sai-ydev/pibadge/piboard_bom.xlsx

Comment | Designator | Footprint | LCSC Part #
LiPo Battery Connector | J2 | 1x2P | C295747
12MHz | Q1 | SMD3225-4P | C654952
1K | R14 | 402 | C3015791
0.1uF | C1 C2 C5 C6 C7 C8 C9 C10 C11 C12 C13 C14 C22 C23 C25 C27 C29 C43 | 402 | C141382
1.0uF | C3 C4 | 402 | C968773
2.2nH | L2 | 402 | C370207
2.5A/30V/105mÎ© | Q2 | SOT23-3 | C5182052
2K | R13 | 402 | C5140070
4.7K | R5 R6 | 402 | C3152117
4.7uF | C17 C18 | C0402 | C5157687
5.1K | R8 R9 | 402 | C325521
10K | R3 R4 R7 R11 | 402 | C3015825
10uF | C15 C16 | C0402 | C2846677
20K | R15 | 402 | C3015841
20V-1A | D3 | SOD-123 | C5204747
22uF | C42 | AVX-A | C11366
27 | R1 R2 | 402 | C3017455
30pf | C20 C21 | C0402 | C5182450
100K | R16 R17 R18 | 402 | C3015887
220 | R19 | 402 | C3017470
330 | R10 | 402 | C3015774
470 | R12 | 402 | C3015779
470nF 50V | C19 C24 C26 C28 | C0402 | C967572
BLUE-0402 | D1 D2 | LED-0402 | C130724
BMI270 | U2 | XDCR_BMI270 | C2836813
FIDUCIAL1X2 | FD2 FD4 FD6 | FIDUCIAL-1X2 | DNF
ICS-41350 | MK1 | MIC_ICS-41350 | C2895290
IS25LP256D-JLLE-TR | IC1 | SON127P800X600X80-9N | C2886434
IS31FL3737-QFLS4-TR | IC2 | QFN40P500X500X80-41N | C506254
JUMPER-SMT_2_NO_SILK_ROUND | JP1 | SMT-JUMPER_2_NO_SILK_ROUND | DNF
MCP73831T-2ATI/OT | U4 | SOT95P280X145-5N | C14879
MIC5504-3.3YM5_TR | U3 | SOT95P280X145-5N | C3021093
MOMENTARY-SWITCH-SPST-SMD-4.6X2.8MM | S1 S2 S3 | TACTILE_SWITCH_SMD_4.6X2.8MM | C99271
PCM12SMTR | SW1 | SW_PCM12SMTR | C221841
RED-0402 | D4 | LED-0402 | C130719
RP2040 | U1 | QFN40P700X700X90-57N | C2040
TYPE-C-31-M-12 | J1 | HRO_TYPE-C-31-M-12 | C165948
19-337C/RSBHGHC-A88/4T | RGB1 RGB2 RGB3 RGB4 RGB5 RGB6 RGB7 RGB8 RGB9 RGB10 RGB11 RGB12 RGB13 RGB14 RGB15 RGB16 RGB17 RGB18 RGB19 RGB20 RGB21 RGB22 RGB23 RGB24 RGB25 RGB26 RGB27 RGB28 RGB29 RGB30 RGB31 RGB32 RGB33 RGB34 RGB35 RGB36 RGB37 RGB38 RGB39 RGB40 RGB41 RGB42 RGB43 RGB44 RGB45 RGB46 RGB47 RGB48 | LED_19-337C/RSBHGHC-A88/4T | C3019536
100nf | C30 C31 C32 C33 C34 C35 C36 C37 C38 C39 C40 C41 | C0402 | C141382
FIDUCIAL1X2 | FD1 FD3 FD5 | FIDUCIAL-1X2 | DNF
WS2812B-2020 | LED1 LED2 LED3 LED4 LED5 LED6 LED7 LED8 LED9 LED10 LED11 LED12 | WS2812B-2020 | C965555
