sai-ydev/pibadge/piboard.brd

## EAGLE design piboard.brd (2023-02-13)

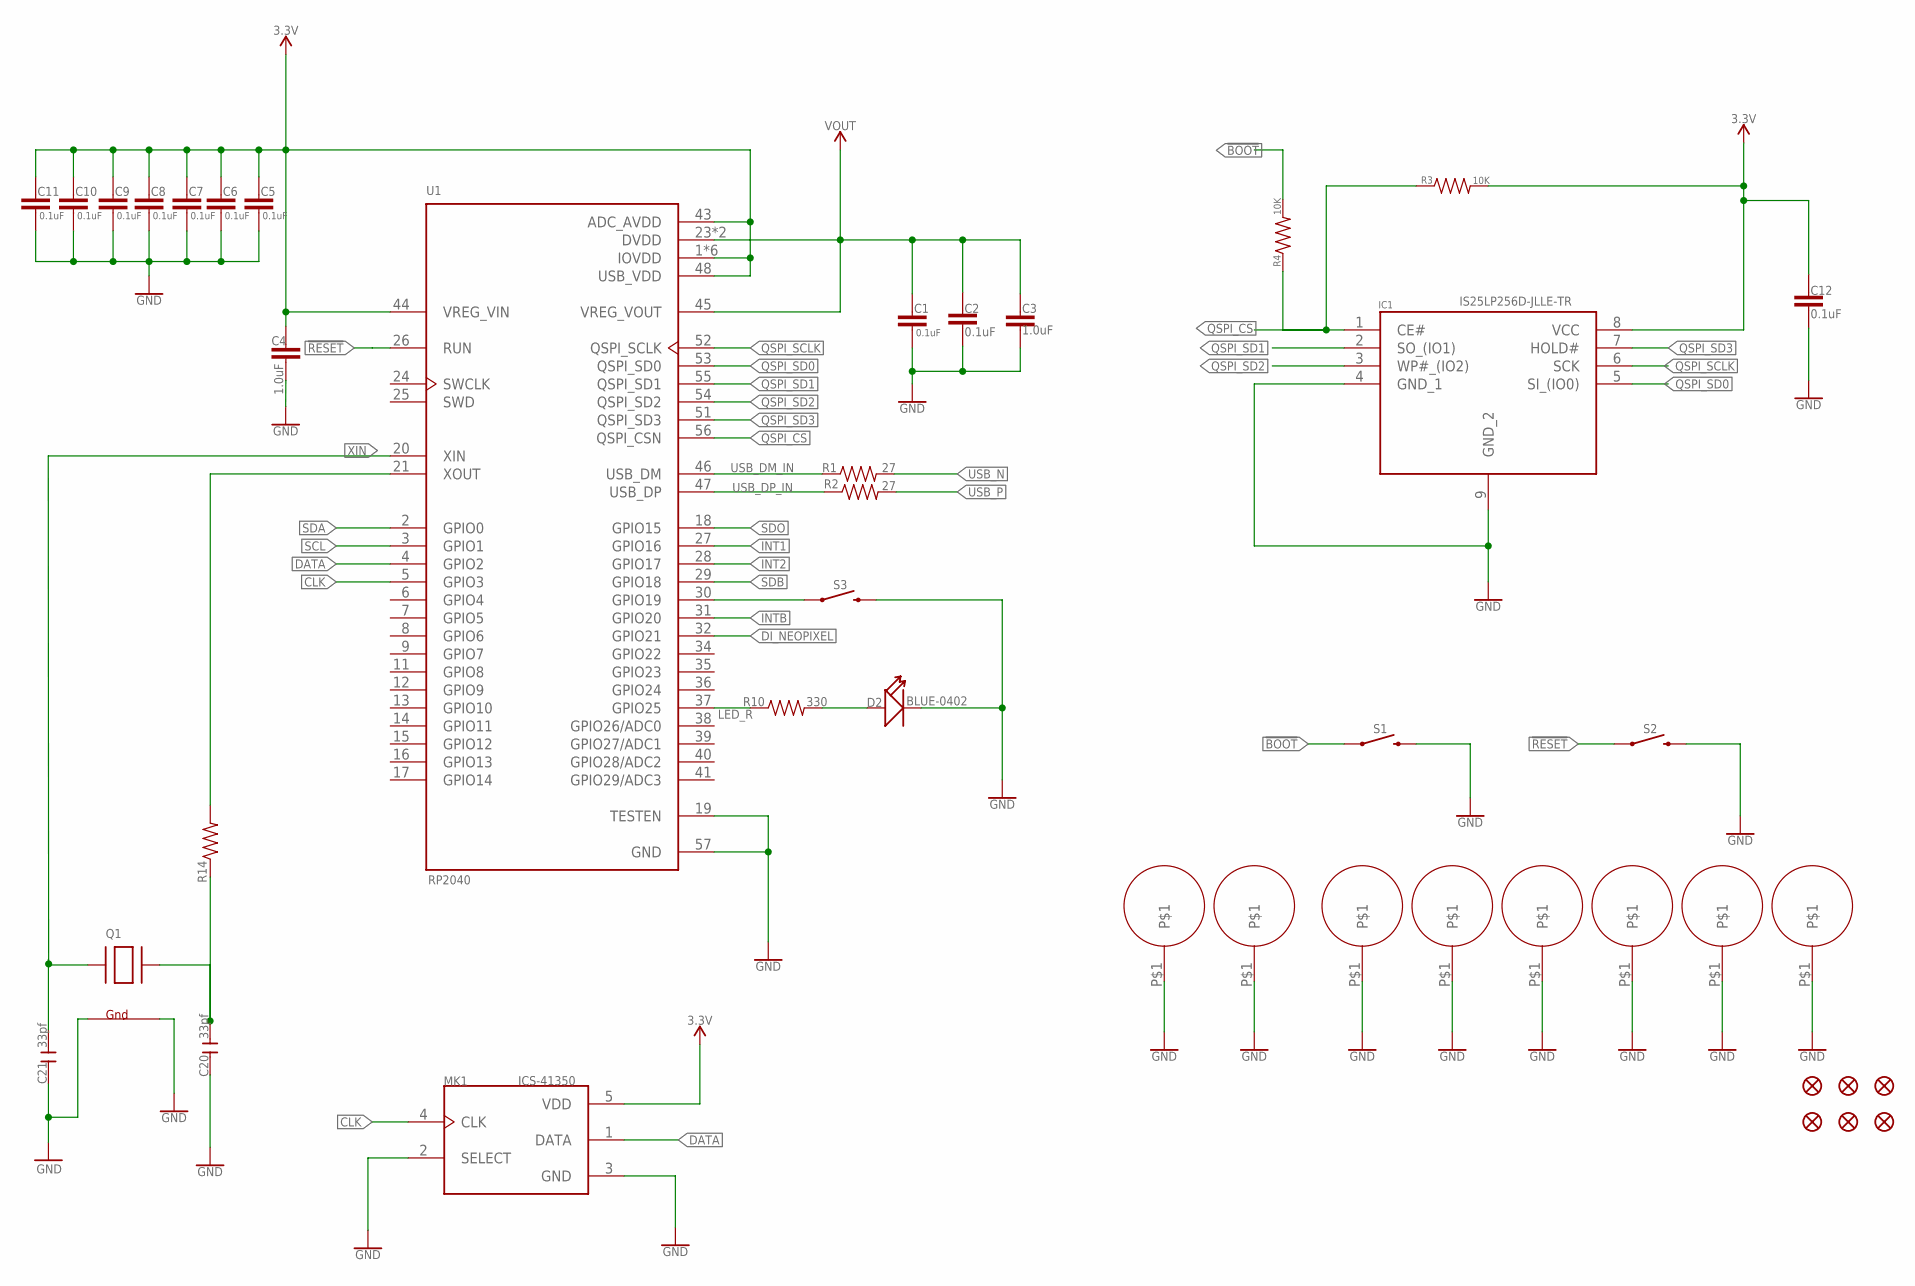
[picture p1: schematic piboard.sch, sheet 1]

Parts:
C1, C2, C5, C6, C7, C8, C9, C10, C11, C12: 0.1uF; 0402
C3, C4: 1.0uF; 0402
C20, C21: 33pf; C0402
D2: BLUE-0402; LED-0402
FD1, FD2, FD3, FD4, FD5, FD6: FIDUCIAL1X2; FIDUCIAL-1X2
H1, H2, H3, H4, H5, H6, H7, H8: M25
IC1: IS25LP256D-JLLE-TR; SON127P800X600X80-9N
MK1: ICS-41350; MIC_ICS-41350
Q1: XTAL-4-3225; NX3225
R1, R2: 27; 0402
R3, R4: 10K; 0402
R10: 330; 0402
R14: 0402
S1, S2, S3: MOMENTARY-SWITCH-SPST-SMD-4.6X2.8MM; TACTILE_SWITCH_SMD_4.6X2.8MM
U1: RP2040; QFN40P700X700X90-57N

Connections:
3.3V: C4.1, C5.1, C6.1, C7.1, C8.1, C9.1, C10.1, C11.1, C12.1, IC1.8 (VCC), MK1.5 (VDD), R3.2, U1.1 (IOVDD), U1.10 (IOVDD), U1.22 (IOVDD), U1.33 (IOVDD), U1.42 (IOVDD), U1.43 (ADC_AVDD), U1.44 (VREG_VIN), U1.48 (USB_VDD), U1.49 (IOVDD); also elsewhere on the board
!BOOT: R4.2, S1.1, S1.2 (1)
!RESET: S2.1, S2.2 (1), U1.26 (RUN)
CLK: MK1.4 (CLK), U1.5 (GPIO3)
DATA: MK1.1 (DATA), U1.4 (GPIO2)
DI_NEOPIXEL: U1.32 (GPIO21); also elsewhere on the board
GND: C1.2, C2.2, C3.2, C4.2, C5.2, C6.2, C7.2, C8.2, C9.2, C10.2, C11.2, C12.2, C20.1, C21.1, D2.-, H1.P$1, H2.P$1, H3.P$1, H4.P$1, H5.P$1, H6.P$1, H7.P$1, H8.P$1, IC1.4 (GND_1), IC1.9 (GND_2), MK1.2 (SELECT), MK1.3 (GND), Q1.2 (G2), Q1.4 (G1), S1.3 (2), S1.4 (2), S2.3 (2), S2.4 (2), S3.3 (2), S3.4 (2), U1.19 (TESTEN), U1.57 (GND); also elsewhere on the board
INT1: U1.27 (GPIO16); also elsewhere on the board
INT2: U1.28 (GPIO17); also elsewhere on the board
INTB: U1.31 (GPIO20); also elsewhere on the board
LED_R: R10.1, U1.37 (GPIO25)
unnamed: D2.+, R10.2
unnamed: C20.2, Q1.3 (X2), R14.1
unnamed: R14.2, U1.21 (XOUT)
unnamed: S3.1, S3.2 (1), U1.30 (GPIO19)
QSPI_CS: IC1.1 (CE#), R3.1, R4.1, U1.56 (QSPI_CSN)
QSPI_SCLK: IC1.6 (SCK), U1.52 (QSPI_SCLK)
QSPI_SD0: IC1.5 (SI_(IO0)), U1.53 (QSPI_SD0)
QSPI_SD1: IC1.2 (SO_(IO1)), U1.55 (QSPI_SD1)
QSPI_SD2: IC1.3 (WP#_(IO2)), U1.54 (QSPI_SD2)
QSPI_SD3: IC1.7 (HOLD#), U1.51 (QSPI_SD3)
SCL: U1.3 (GPIO1); also elsewhere on the board
SDA: U1.2 (GPIO0); also elsewhere on the board
SDB: U1.29 (GPIO18); also elsewhere on the board
SDO: U1.18 (GPIO15); also elsewhere on the board
USB_DM_IN: R1.1, U1.46 (USB_DM)
USB_DP_IN: R2.1, U1.47 (USB_DP)
USB_N: R1.2; also elsewhere on the board
USB_P: R2.2; also elsewhere on the board
VOUT: C1.1, C2.1, C3.1, U1.23 (DVDD), U1.45 (VREG_VOUT), U1.50 (DVDD)
XIN: C21.2, Q1.1 (X1), U1.20 (XIN)

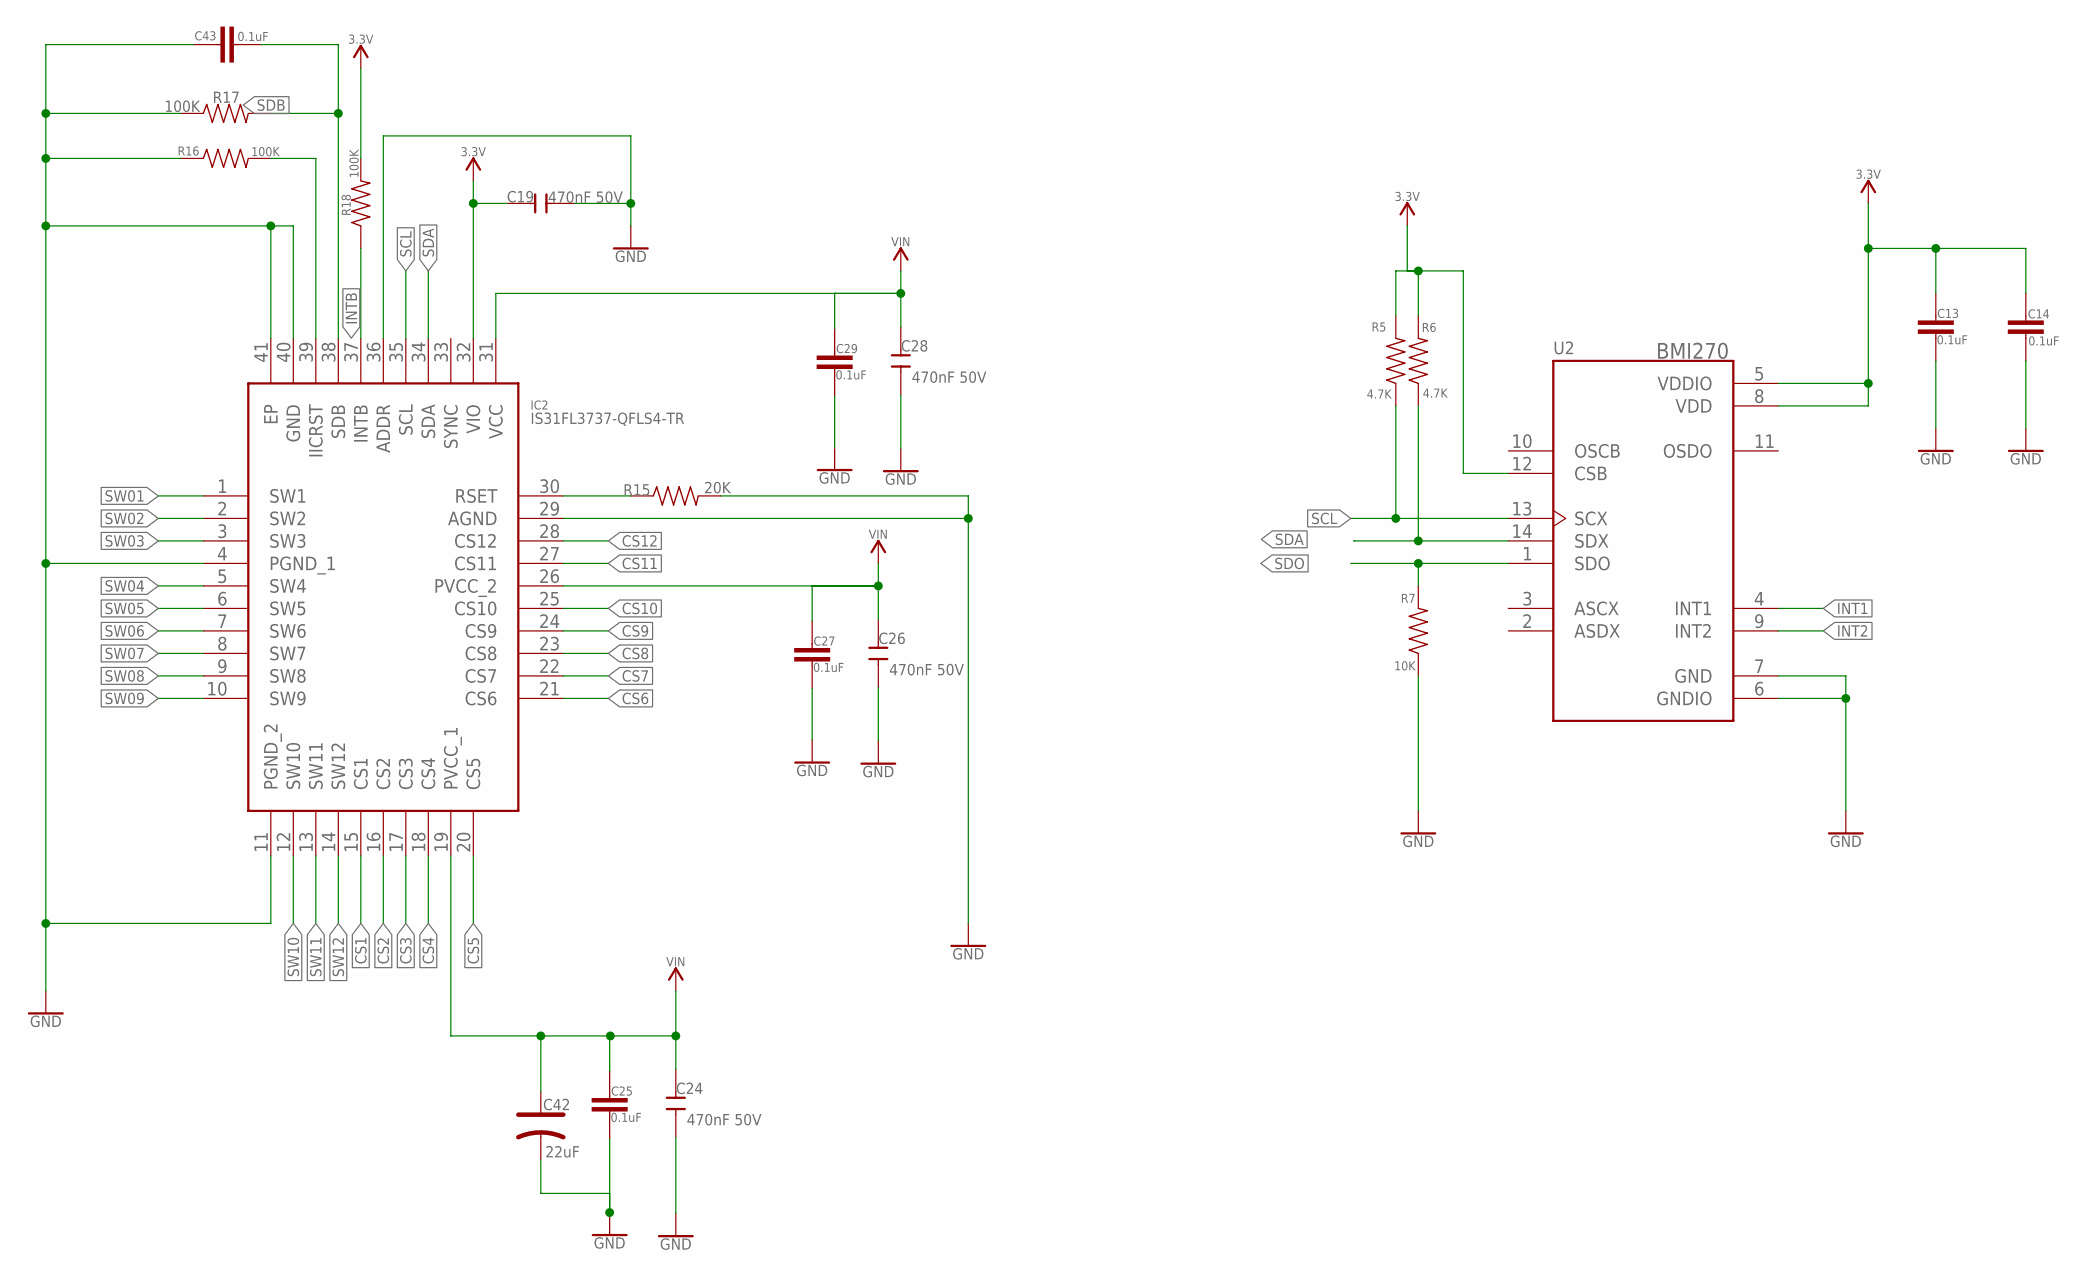
[picture p2: schematic piboard.sch, sheet 2]

Parts:
C13, C14, C25, C27, C29, C43: 0.1uF; 0402
C19, C24, C26, C28: 470nF 50V; C0402
C42: 22uF; AVX-A
IC2: IS31FL3737-QFLS4-TR; QFN40P500X500X80-41N
R5, R6: 4.7K; 0402
R7: 10K; 0402
R15: 20K; 0402
R16, R17, R18: 100K; 0402
U2: BMI270; XDCR_BMI270

Connections:
3.3V: C13.1, C14.1, C19.1, IC2.32 (VIO), R5.2, R6.2, R18.2, U2.5 (VDDIO), U2.8 (VDD), U2.12 (CSB); also elsewhere on the board
CS1: IC2.15 (CS1); also elsewhere on the board
CS2: IC2.16 (CS2); also elsewhere on the board
CS3: IC2.17 (CS3); also elsewhere on the board
CS4: IC2.18 (CS4); also elsewhere on the board
CS5: IC2.20 (CS5); also elsewhere on the board
CS6: IC2.21 (CS6); also elsewhere on the board
CS7: IC2.22 (CS7); also elsewhere on the board
CS8: IC2.23 (CS8); also elsewhere on the board
CS9: IC2.24 (CS9); also elsewhere on the board
CS10: IC2.25 (CS10); also elsewhere on the board
CS11: IC2.27 (CS11); also elsewhere on the board
CS12: IC2.28 (CS12); also elsewhere on the board
GND: C13.2, C14.2, C19.2, C24.1, C25.2, C26.1, C27.2, C28.1, C29.2, C42.-, C43.1, IC2.4 (PGND_1), IC2.11 (PGND_2), IC2.29 (AGND), IC2.36 (ADDR), IC2.40 (GND), IC2.41 (EP), R7.1, R15.2, R16.1, R17.1, U2.6 (GNDIO), U2.7 (GND); also elsewhere on the board
INT1: U2.4 (INT1); also elsewhere on the board
INT2: U2.9 (INT2); also elsewhere on the board
INTB: IC2.37 (INTB), R18.1; also elsewhere on the board
unnamed: IC2.30 (RSET), R15.1
unnamed: IC2.39 (IICRST), R16.2
SCL: IC2.35 (SCL), R5.1, U2.13 (SCX); also elsewhere on the board
SDA: IC2.34 (SDA), R6.1, U2.14 (SDX); also elsewhere on the board
SDB: C43.2, IC2.38 (SDB), R17.2; also elsewhere on the board
SDO: R7.2, U2.1 (SDO); also elsewhere on the board
SW01: IC2.1 (SW1); also elsewhere on the board
SW02: IC2.2 (SW2); also elsewhere on the board
SW03: IC2.3 (SW3); also elsewhere on the board
SW04: IC2.5 (SW4); also elsewhere on the board
SW05: IC2.6 (SW5); also elsewhere on the board
SW06: IC2.7 (SW6); also elsewhere on the board
SW07: IC2.8 (SW7); also elsewhere on the board
SW08: IC2.9 (SW8); also elsewhere on the board
SW09: IC2.10 (SW9); also elsewhere on the board
SW10: IC2.12 (SW10); also elsewhere on the board
SW11: IC2.13 (SW11); also elsewhere on the board
SW12: IC2.14 (SW12); also elsewhere on the board
VIN: C24.2, C25.1, C26.2, C27.1, C28.2, C29.1, C42.+, IC2.19 (PVCC_1), IC2.26 (PVCC_2), IC2.31 (VCC); also elsewhere on the board

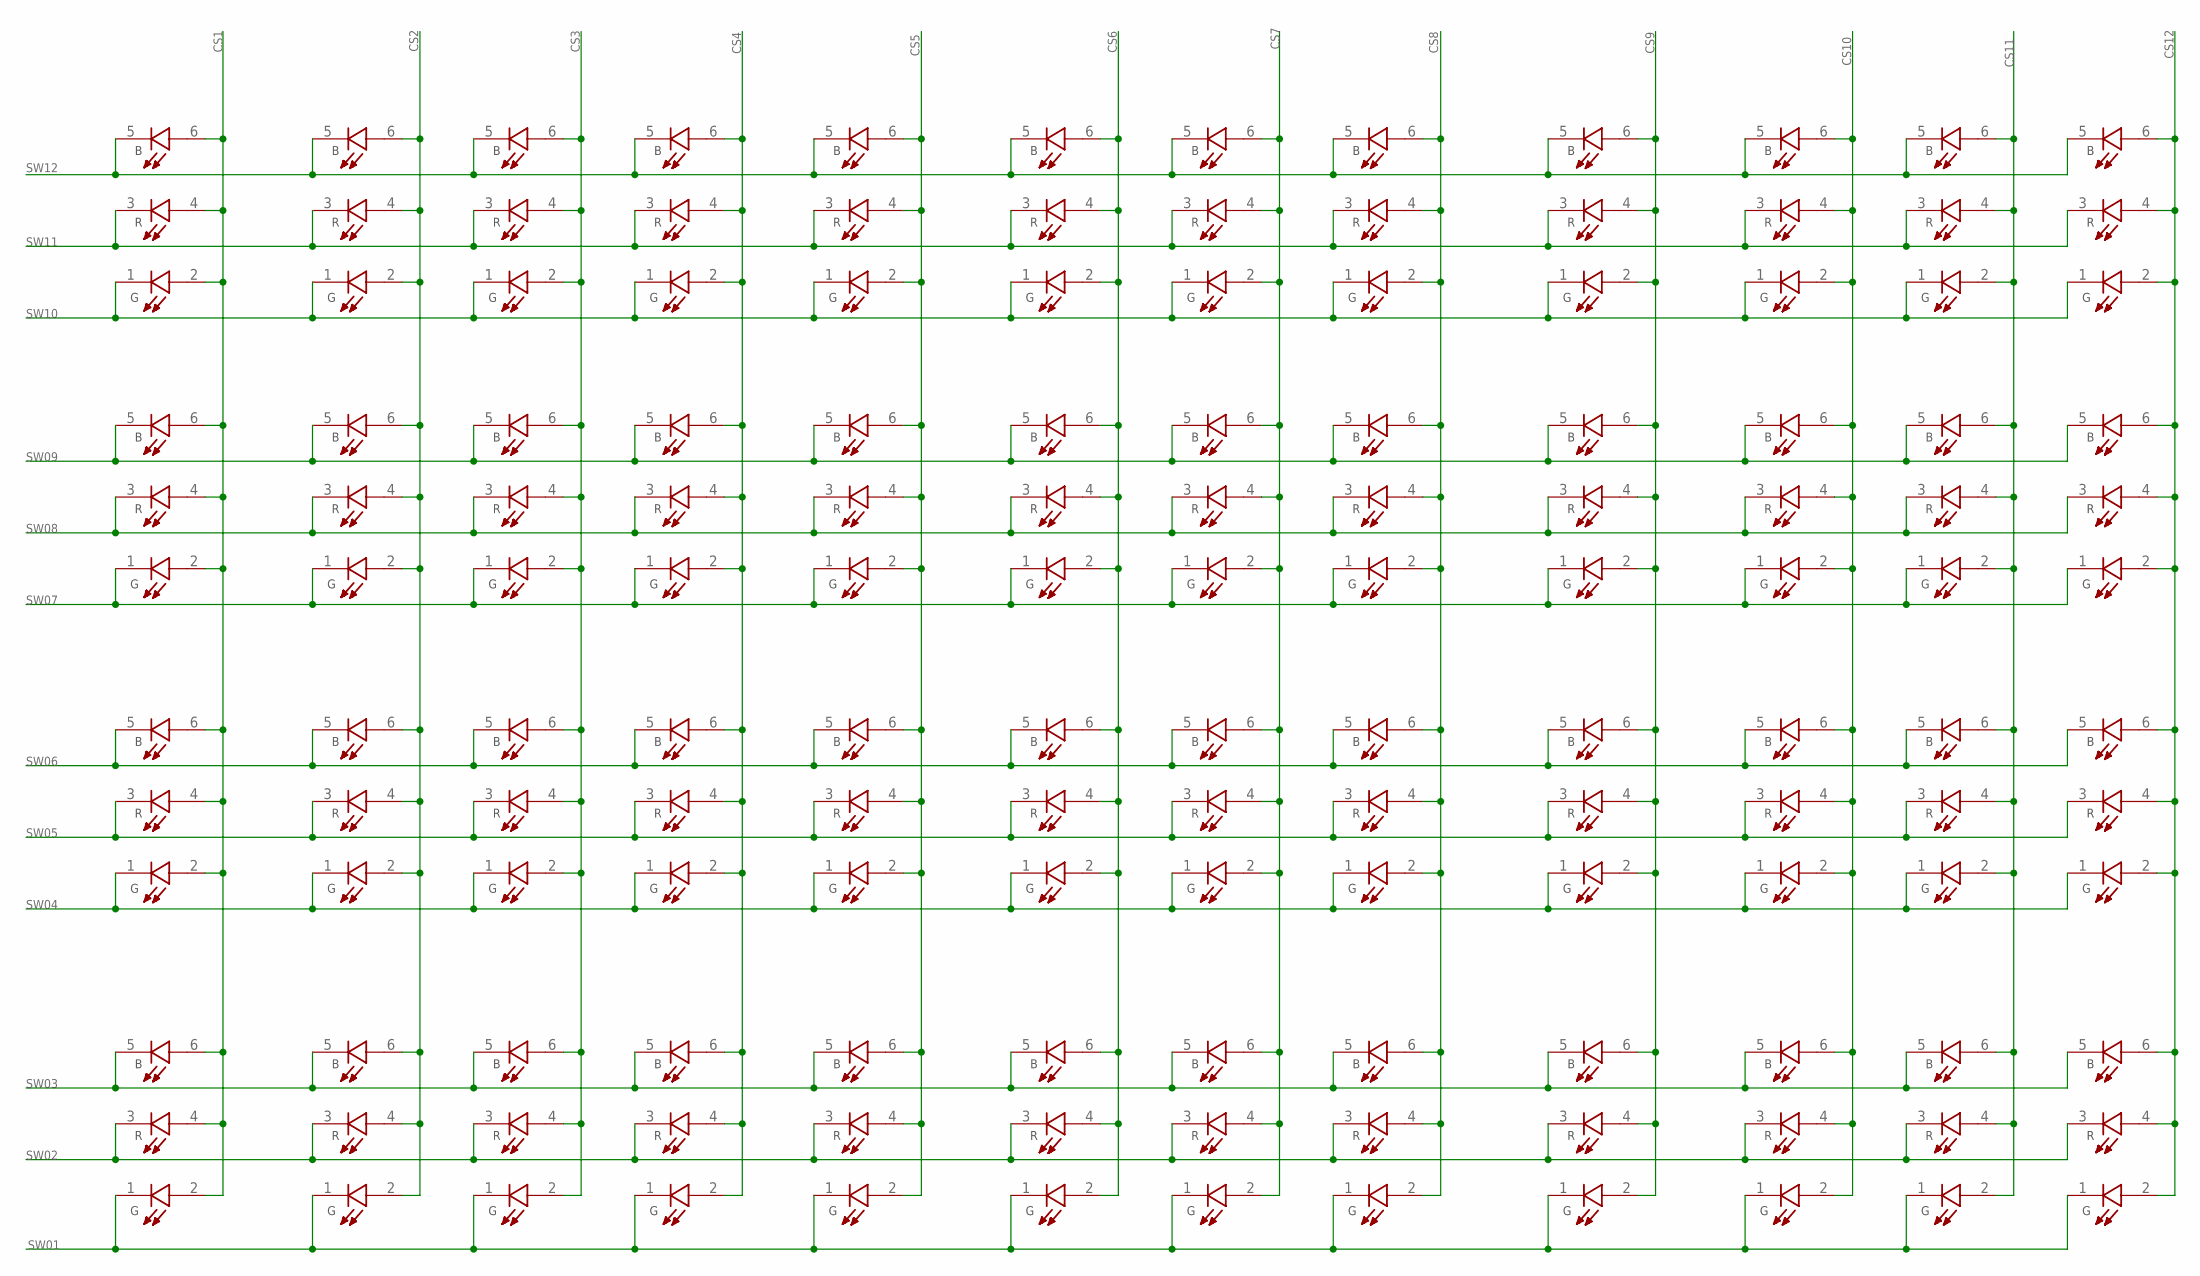
[picture p3: schematic piboard.sch, sheet 3]

Parts:
RGB1, RGB2, RGB3, RGB4, RGB5, RGB6, RGB7, RGB8, RGB9, RGB10, RGB11, RGB12, RGB13, RGB14, RGB15, RGB16, RGB17, RGB18, RGB19, RGB20, RGB21, RGB22, RGB23, RGB24, RGB25, RGB26, RGB27, RGB28, RGB29, RGB30, RGB31, RGB32, RGB33, RGB34, RGB35, RGB36, RGB37, RGB38, RGB39, RGB40, RGB41, RGB42, RGB43, RGB44, RGB45, RGB46, RGB47, RGB48: 19-337C/RSBHGHC-A88/4T; LED_19-337C/RSBHGHC-A88/4T

Connections:
CS1: RGB1.2 (G_A), RGB1.4 (R_A), RGB1.6 (B_A), RGB13.2 (G_A), RGB13.4 (R_A), RGB13.6 (B_A), RGB25.2 (G_A), RGB25.4 (R_A), RGB25.6 (B_A), RGB37.2 (G_A), RGB37.4 (R_A), RGB37.6 (B_A); also elsewhere on the board
CS2: RGB2.2 (G_A), RGB2.4 (R_A), RGB2.6 (B_A), RGB14.2 (G_A), RGB14.4 (R_A), RGB14.6 (B_A), RGB26.2 (G_A), RGB26.4 (R_A), RGB26.6 (B_A), RGB38.2 (G_A), RGB38.4 (R_A), RGB38.6 (B_A); also elsewhere on the board
CS3: RGB3.2 (G_A), RGB3.4 (R_A), RGB3.6 (B_A), RGB15.2 (G_A), RGB15.4 (R_A), RGB15.6 (B_A), RGB27.2 (G_A), RGB27.4 (R_A), RGB27.6 (B_A), RGB39.2 (G_A), RGB39.4 (R_A), RGB39.6 (B_A); also elsewhere on the board
CS4: RGB4.2 (G_A), RGB4.4 (R_A), RGB4.6 (B_A), RGB16.2 (G_A), RGB16.4 (R_A), RGB16.6 (B_A), RGB28.2 (G_A), RGB28.4 (R_A), RGB28.6 (B_A), RGB40.2 (G_A), RGB40.4 (R_A), RGB40.6 (B_A); also elsewhere on the board
CS5: RGB5.2 (G_A), RGB5.4 (R_A), RGB5.6 (B_A), RGB17.2 (G_A), RGB17.4 (R_A), RGB17.6 (B_A), RGB29.2 (G_A), RGB29.4 (R_A), RGB29.6 (B_A), RGB41.2 (G_A), RGB41.4 (R_A), RGB41.6 (B_A); also elsewhere on the board
CS6: RGB6.2 (G_A), RGB6.4 (R_A), RGB6.6 (B_A), RGB18.2 (G_A), RGB18.4 (R_A), RGB18.6 (B_A), RGB30.2 (G_A), RGB30.4 (R_A), RGB30.6 (B_A), RGB42.2 (G_A), RGB42.4 (R_A), RGB42.6 (B_A); also elsewhere on the board
CS7: RGB7.2 (G_A), RGB7.4 (R_A), RGB7.6 (B_A), RGB19.2 (G_A), RGB19.4 (R_A), RGB19.6 (B_A), RGB31.2 (G_A), RGB31.4 (R_A), RGB31.6 (B_A), RGB43.2 (G_A), RGB43.4 (R_A), RGB43.6 (B_A); also elsewhere on the board
CS8: RGB8.2 (G_A), RGB8.4 (R_A), RGB8.6 (B_A), RGB20.2 (G_A), RGB20.4 (R_A), RGB20.6 (B_A), RGB32.2 (G_A), RGB32.4 (R_A), RGB32.6 (B_A), RGB44.2 (G_A), RGB44.4 (R_A), RGB44.6 (B_A); also elsewhere on the board
CS9: RGB9.2 (G_A), RGB9.4 (R_A), RGB9.6 (B_A), RGB21.2 (G_A), RGB21.4 (R_A), RGB21.6 (B_A), RGB33.2 (G_A), RGB33.4 (R_A), RGB33.6 (B_A), RGB45.2 (G_A), RGB45.4 (R_A), RGB45.6 (B_A); also elsewhere on the board
CS10: RGB10.2 (G_A), RGB10.4 (R_A), RGB10.6 (B_A), RGB22.2 (G_A), RGB22.4 (R_A), RGB22.6 (B_A), RGB34.2 (G_A), RGB34.4 (R_A), RGB34.6 (B_A), RGB46.2 (G_A), RGB46.4 (R_A), RGB46.6 (B_A); also elsewhere on the board
CS11: RGB11.2 (G_A), RGB11.4 (R_A), RGB11.6 (B_A), RGB23.2 (G_A), RGB23.4 (R_A), RGB23.6 (B_A), RGB35.2 (G_A), RGB35.4 (R_A), RGB35.6 (B_A), RGB47.2 (G_A), RGB47.4 (R_A), RGB47.6 (B_A); also elsewhere on the board
CS12: RGB12.2 (G_A), RGB12.4 (R_A), RGB12.6 (B_A), RGB24.2 (G_A), RGB24.4 (R_A), RGB24.6 (B_A), RGB36.2 (G_A), RGB36.4 (R_A), RGB36.6 (B_A), RGB48.2 (G_A), RGB48.4 (R_A), RGB48.6 (B_A); also elsewhere on the board
SW01: RGB37.1 (G_C), RGB38.1 (G_C), RGB39.1 (G_C), RGB40.1 (G_C), RGB41.1 (G_C), RGB42.1 (G_C), RGB43.1 (G_C), RGB44.1 (G_C), RGB45.1 (G_C), RGB46.1 (G_C), RGB47.1 (G_C), RGB48.1 (G_C); also elsewhere on the board
SW02: RGB37.3 (R_C), RGB38.3 (R_C), RGB39.3 (R_C), RGB40.3 (R_C), RGB41.3 (R_C), RGB42.3 (R_C), RGB43.3 (R_C), RGB44.3 (R_C), RGB45.3 (R_C), RGB46.3 (R_C), RGB47.3 (R_C), RGB48.3 (R_C); also elsewhere on the board
SW03: RGB37.5 (B_C), RGB38.5 (B_C), RGB39.5 (B_C), RGB40.5 (B_C), RGB41.5 (B_C), RGB42.5 (B_C), RGB43.5 (B_C), RGB44.5 (B_C), RGB45.5 (B_C), RGB46.5 (B_C), RGB47.5 (B_C), RGB48.5 (B_C); also elsewhere on the board
SW04: RGB25.1 (G_C), RGB26.1 (G_C), RGB27.1 (G_C), RGB28.1 (G_C), RGB29.1 (G_C), RGB30.1 (G_C), RGB31.1 (G_C), RGB32.1 (G_C), RGB33.1 (G_C), RGB34.1 (G_C), RGB35.1 (G_C), RGB36.1 (G_C); also elsewhere on the board
SW05: RGB25.3 (R_C), RGB26.3 (R_C), RGB27.3 (R_C), RGB28.3 (R_C), RGB29.3 (R_C), RGB30.3 (R_C), RGB31.3 (R_C), RGB32.3 (R_C), RGB33.3 (R_C), RGB34.3 (R_C), RGB35.3 (R_C), RGB36.3 (R_C); also elsewhere on the board
SW06: RGB25.5 (B_C), RGB26.5 (B_C), RGB27.5 (B_C), RGB28.5 (B_C), RGB29.5 (B_C), RGB30.5 (B_C), RGB31.5 (B_C), RGB32.5 (B_C), RGB33.5 (B_C), RGB34.5 (B_C), RGB35.5 (B_C), RGB36.5 (B_C); also elsewhere on the board
SW07: RGB13.1 (G_C), RGB14.1 (G_C), RGB15.1 (G_C), RGB16.1 (G_C), RGB17.1 (G_C), RGB18.1 (G_C), RGB19.1 (G_C), RGB20.1 (G_C), RGB21.1 (G_C), RGB22.1 (G_C), RGB23.1 (G_C), RGB24.1 (G_C); also elsewhere on the board
SW08: RGB13.3 (R_C), RGB14.3 (R_C), RGB15.3 (R_C), RGB16.3 (R_C), RGB17.3 (R_C), RGB18.3 (R_C), RGB19.3 (R_C), RGB20.3 (R_C), RGB21.3 (R_C), RGB22.3 (R_C), RGB23.3 (R_C), RGB24.3 (R_C); also elsewhere on the board
SW09: RGB13.5 (B_C), RGB14.5 (B_C), RGB15.5 (B_C), RGB16.5 (B_C), RGB17.5 (B_C), RGB18.5 (B_C), RGB19.5 (B_C), RGB20.5 (B_C), RGB21.5 (B_C), RGB22.5 (B_C), RGB23.5 (B_C), RGB24.5 (B_C); also elsewhere on the board
SW10: RGB1.1 (G_C), RGB2.1 (G_C), RGB3.1 (G_C), RGB4.1 (G_C), RGB5.1 (G_C), RGB6.1 (G_C), RGB7.1 (G_C), RGB8.1 (G_C), RGB9.1 (G_C), RGB10.1 (G_C), RGB11.1 (G_C), RGB12.1 (G_C); also elsewhere on the board
SW11: RGB1.3 (R_C), RGB2.3 (R_C), RGB3.3 (R_C), RGB4.3 (R_C), RGB5.3 (R_C), RGB6.3 (R_C), RGB7.3 (R_C), RGB8.3 (R_C), RGB9.3 (R_C), RGB10.3 (R_C), RGB11.3 (R_C), RGB12.3 (R_C); also elsewhere on the board
SW12: RGB1.5 (B_C), RGB2.5 (B_C), RGB3.5 (B_C), RGB4.5 (B_C), RGB5.5 (B_C), RGB6.5 (B_C), RGB7.5 (B_C), RGB8.5 (B_C), RGB9.5 (B_C), RGB10.5 (B_C), RGB11.5 (B_C), RGB12.5 (B_C); also elsewhere on the board

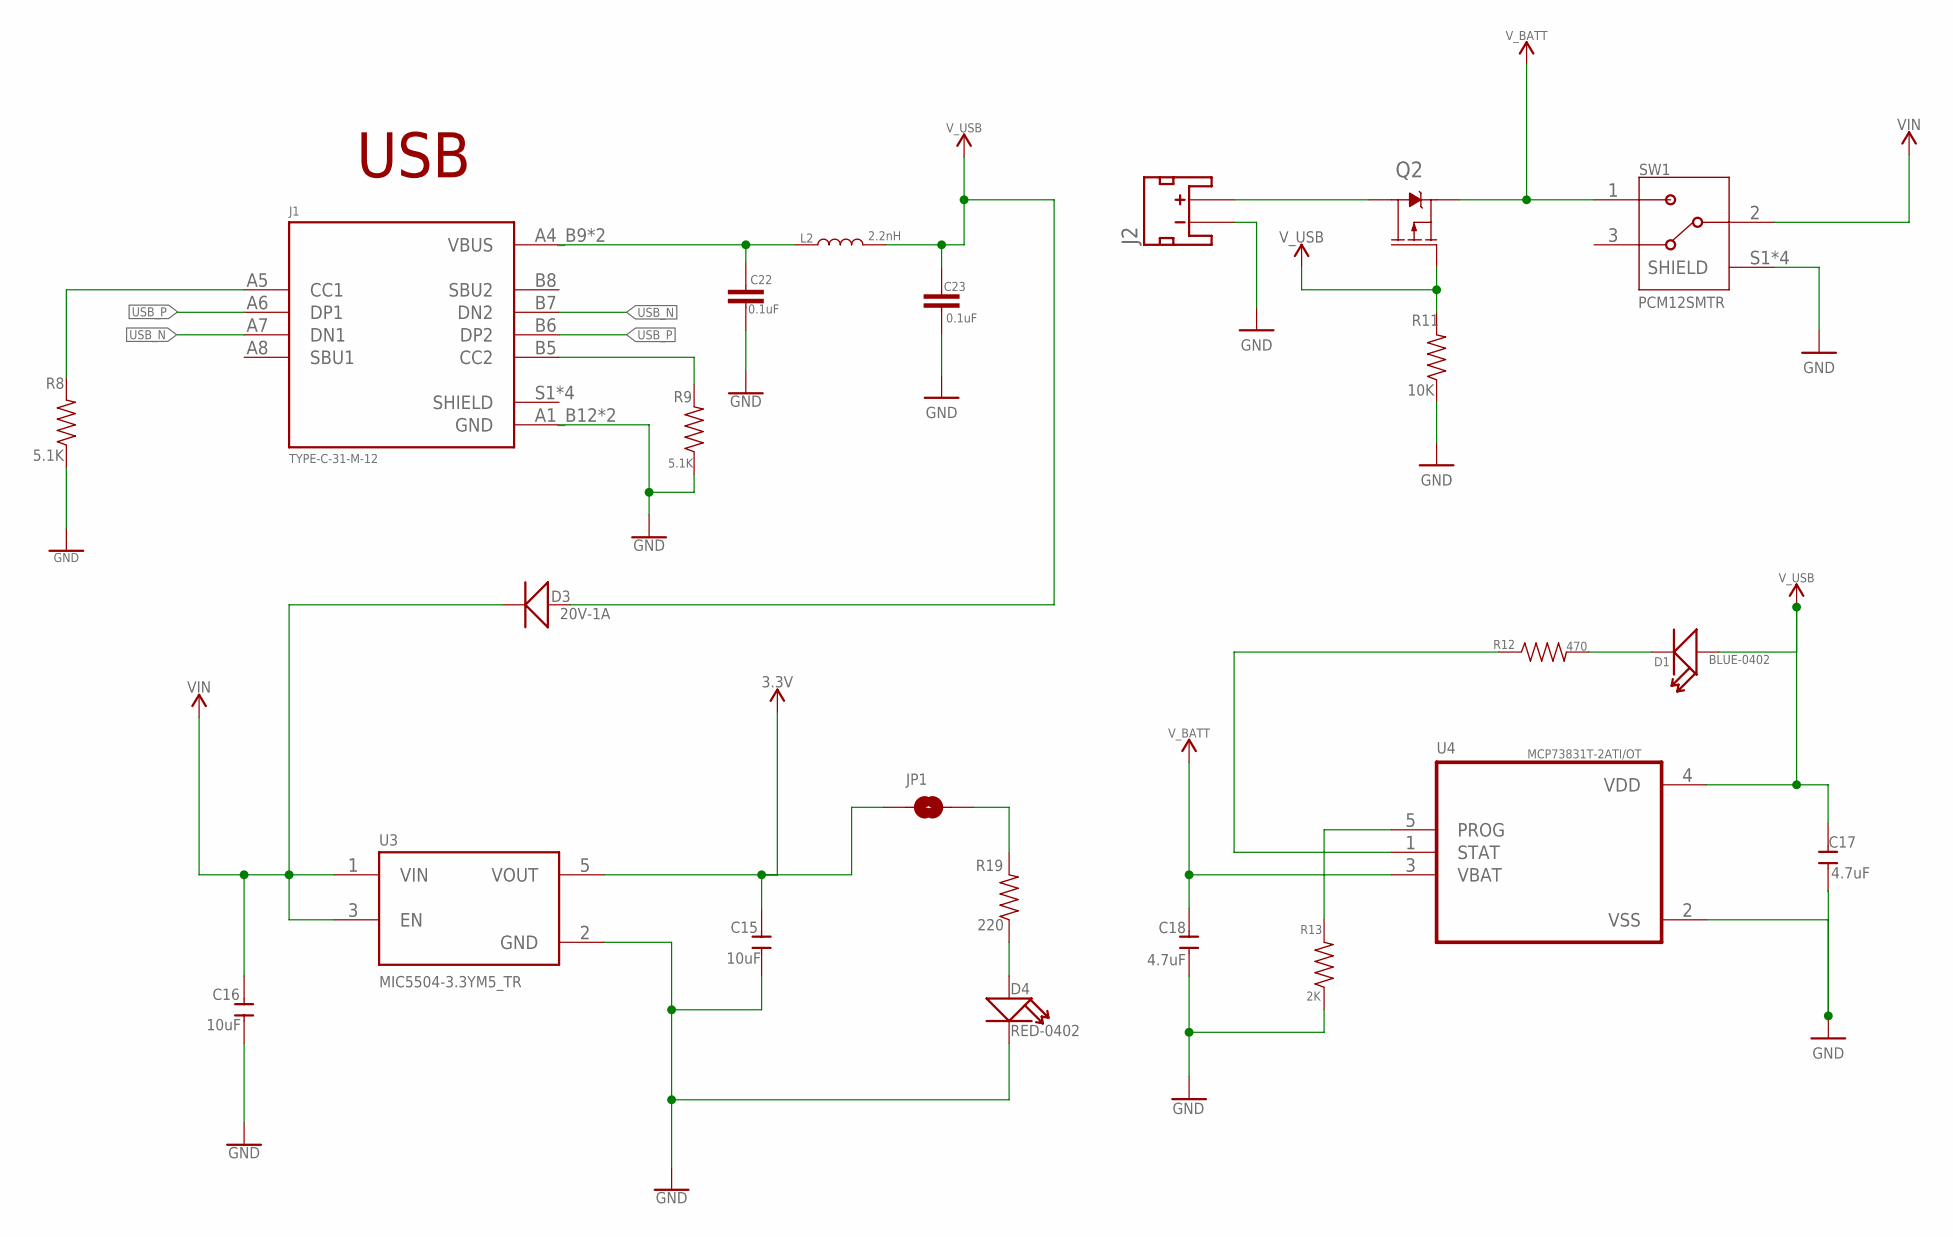
[picture p4: schematic piboard.sch, sheet 4]

Parts:
C15, C16: 10uF; C0402
C17, C18: 4.7uF; C0402
C22, C23: 0.1uF; 0402
D1: BLUE-0402; LED-0402
D3: 20V-1A; SOD-123
D4: RED-0402; LED-0402
J1: TYPE-C-31-M-12; HRO_TYPE-C-31-M-12
J2: JST_2MM_MALE; JST-2-SMD
JP1: JUMPER-SMT_2_NO_SILK_ROUND; SMT-JUMPER_2_NO_SILK_ROUND
L2: 2.2nH; 0402
Q2: 2.5A/30V/105mΩ; SOT23-3
R8, R9: 5.1K; 0402
R11: 10K; 0402
R12: 470; 0402
R13: 2K; 0402
R19: 220; 0402
SW1: PCM12SMTR; SW_PCM12SMTR
U3: MIC5504-3.3YM5_TR; SOT95P280X145-5N
U4: MCP73831T-2ATI/OT; SOT95P280X145-5N

Connections:
3.3V: C15.2, JP1.1, U3.5 (VOUT); also elsewhere on the board
GND: C15.1, C16.1, C17.1, C18.1, C22.2, C23.2, D4.-, J1.A1_B12 (GND), J1.B1_A12 (GND), J2.1 (-), R8.1, R9.1, R11.1, R13.1, SW1.S1 (SHIELD), SW1.S2 (SHIELD), SW1.S3 (SHIELD), SW1.S4 (SHIELD), U3.2 (GND), U4.2 (VSS); also elsewhere on the board
unnamed: J1.A5 (CC1), R8.2
unnamed: J1.B5 (CC2), R9.2
unnamed: J2.2 (+), Q2.3 (D)
unnamed: D1.-, R12.2
unnamed: R12.1, U4.1 (STAT)
unnamed: C22.1, J1.A4_B9 (VBUS), J1.B4_A9 (VBUS), L2.1
unnamed: R13.2, U4.5 (PROG)
unnamed: D4.+, R19.1
unnamed: JP1.2, R19.2
USB_N: J1.A7 (DN1), J1.B7 (DN2); also elsewhere on the board
USB_P: J1.A6 (DP1), J1.B6 (DP2); also elsewhere on the board
VIN: C16.2, D3.-, SW1.2, U3.1 (VIN), U3.3 (EN); also elsewhere on the board
V_BATT: C18.2, Q2.2 (S), SW1.1, U4.3 (VBAT)
V_USB: C17.2, C23.1, D1.+, D3.+, L2.2, Q2.1 (G), R11.2, U4.4 (VDD)

Notes on the sheet:
USB

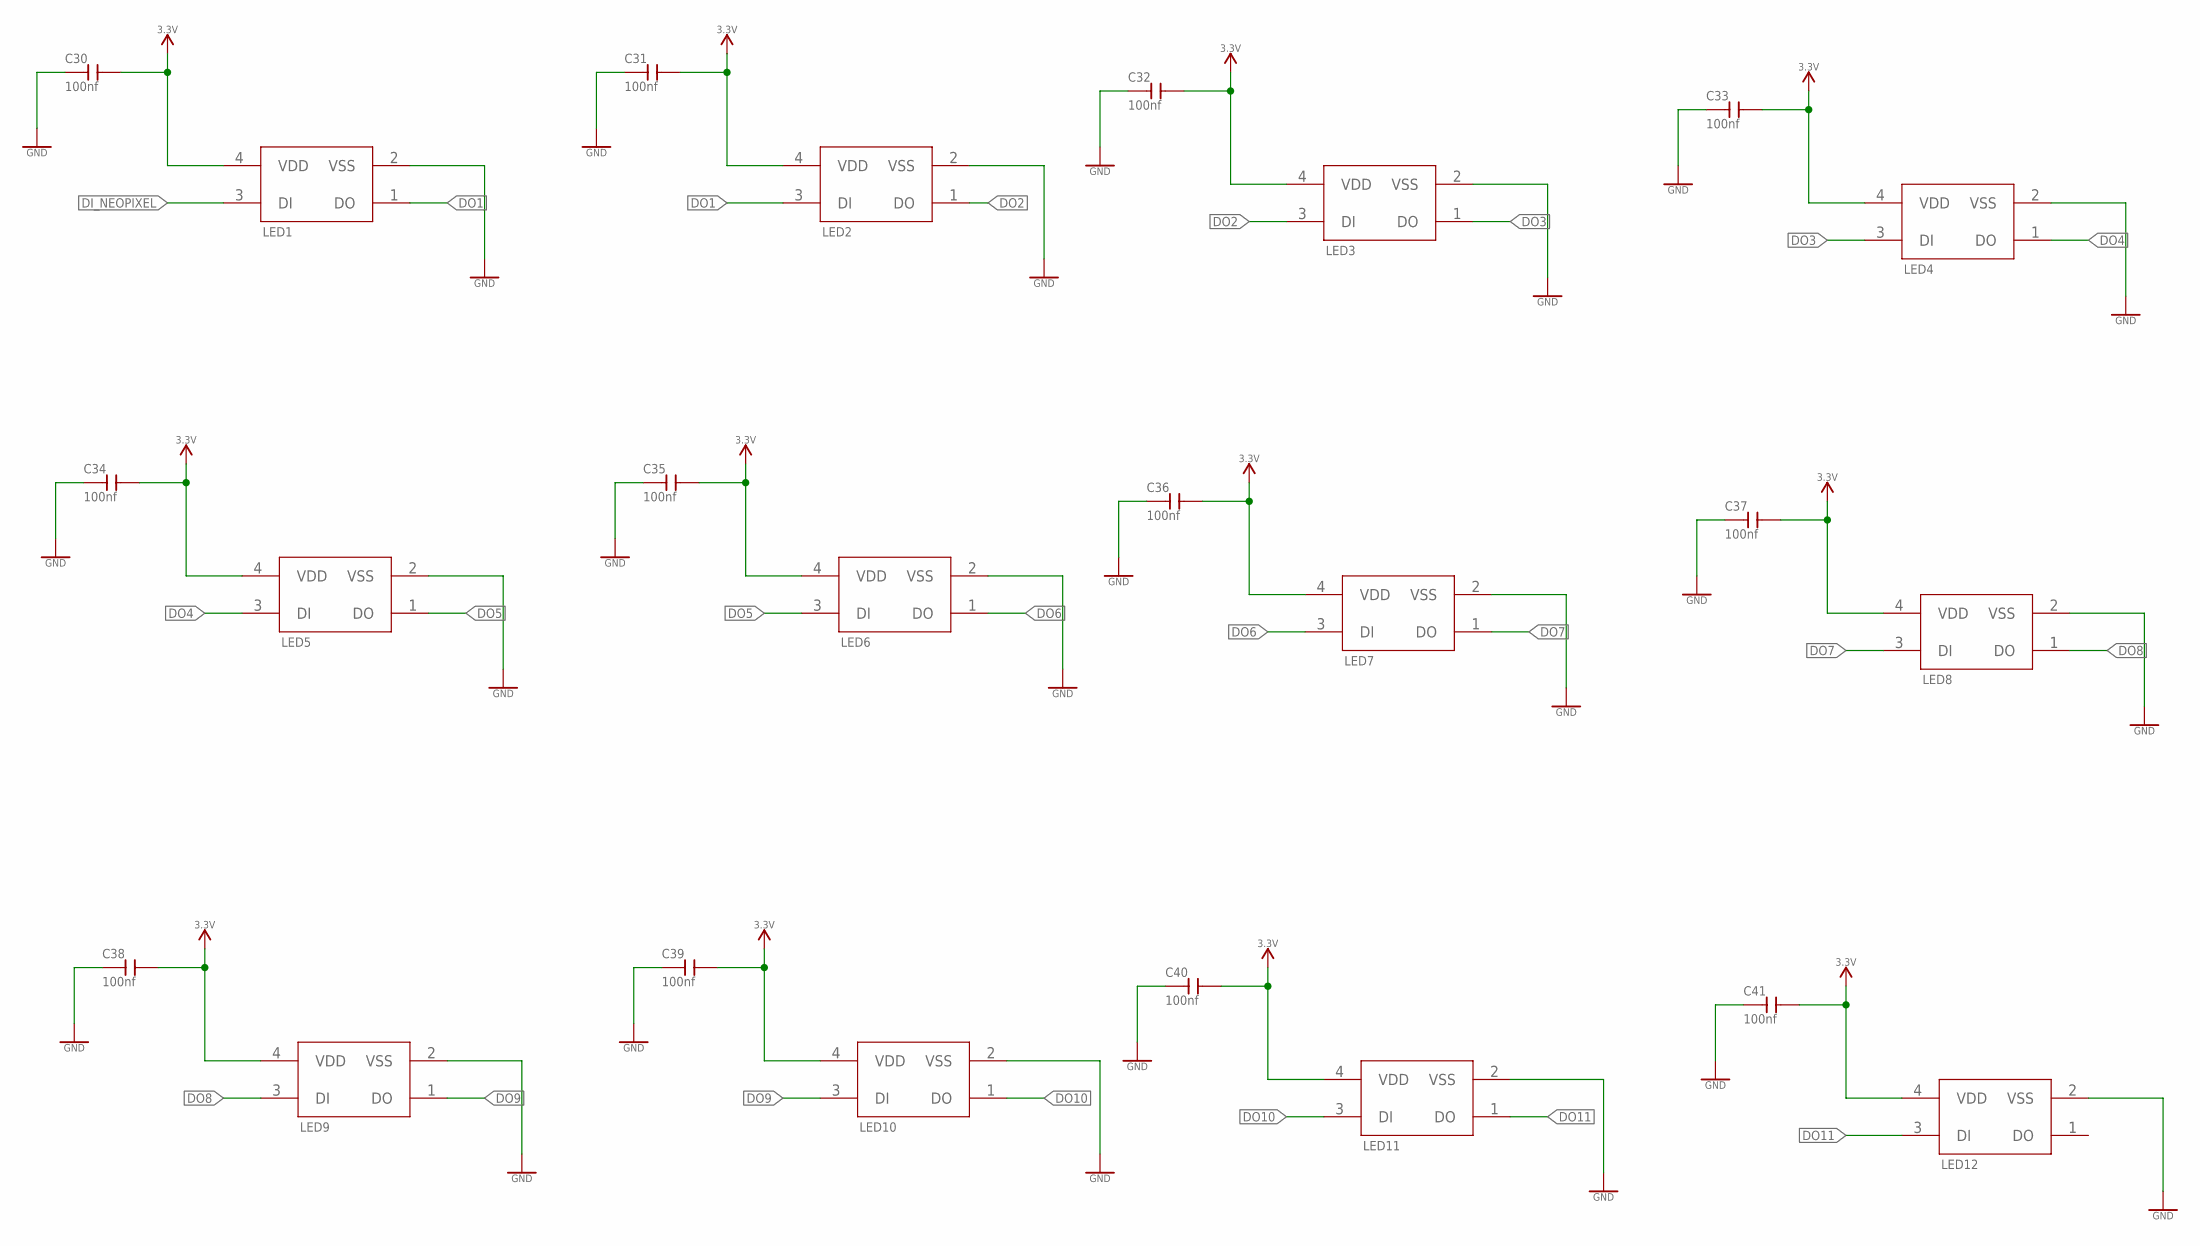
[picture p5: schematic piboard.sch, sheet 5]

Parts:
C30, C31, C32, C33, C34, C35, C36, C37, C38, C39, C40, C41: 100nf; C0402
LED1, LED2, LED3, LED4, LED5, LED6, LED7, LED8, LED9, LED10, LED11, LED12: WS2812B-2020

Connections:
3.3V: C30.2, C31.2, C32.2, C33.2, C34.2, C35.2, C36.2, C37.2, C38.2, C39.2, C40.2, C41.2, LED1.4 (VDD), LED2.4 (VDD), LED3.4 (VDD), LED4.4 (VDD), LED5.4 (VDD), LED6.4 (VDD), LED7.4 (VDD), LED8.4 (VDD), LED9.4 (VDD), LED10.4 (VDD), LED11.4 (VDD), LED12.4 (VDD); also elsewhere on the board
DI_NEOPIXEL: LED1.3 (DI); also elsewhere on the board
DO1: LED1.1 (DO), LED2.3 (DI)
DO2: LED2.1 (DO), LED3.3 (DI)
DO3: LED3.1 (DO), LED4.3 (DI)
DO4: LED4.1 (DO), LED5.3 (DI)
DO5: LED5.1 (DO), LED6.3 (DI)
DO6: LED6.1 (DO), LED7.3 (DI)
DO7: LED7.1 (DO), LED8.3 (DI)
DO8: LED8.1 (DO), LED9.3 (DI)
DO9: LED9.1 (DO), LED10.3 (DI)
DO10: LED10.1 (DO), LED11.3 (DI)
DO11: LED11.1 (DO), LED12.3 (DI)
GND: C30.1, C31.1, C32.1, C33.1, C34.1, C35.1, C36.1, C37.1, C38.1, C39.1, C40.1, C41.1, LED1.2 (VSS), LED2.2 (VSS), LED3.2 (VSS), LED4.2 (VSS), LED5.2 (VSS), LED6.2 (VSS), LED7.2 (VSS), LED8.2 (VSS), LED9.2 (VSS), LED10.2 (VSS), LED11.2 (VSS), LED12.2 (VSS); also elsewhere on the board
