sai-ydev/pibadge/piboard.brd

## EAGLE design piboard.brd (continued)

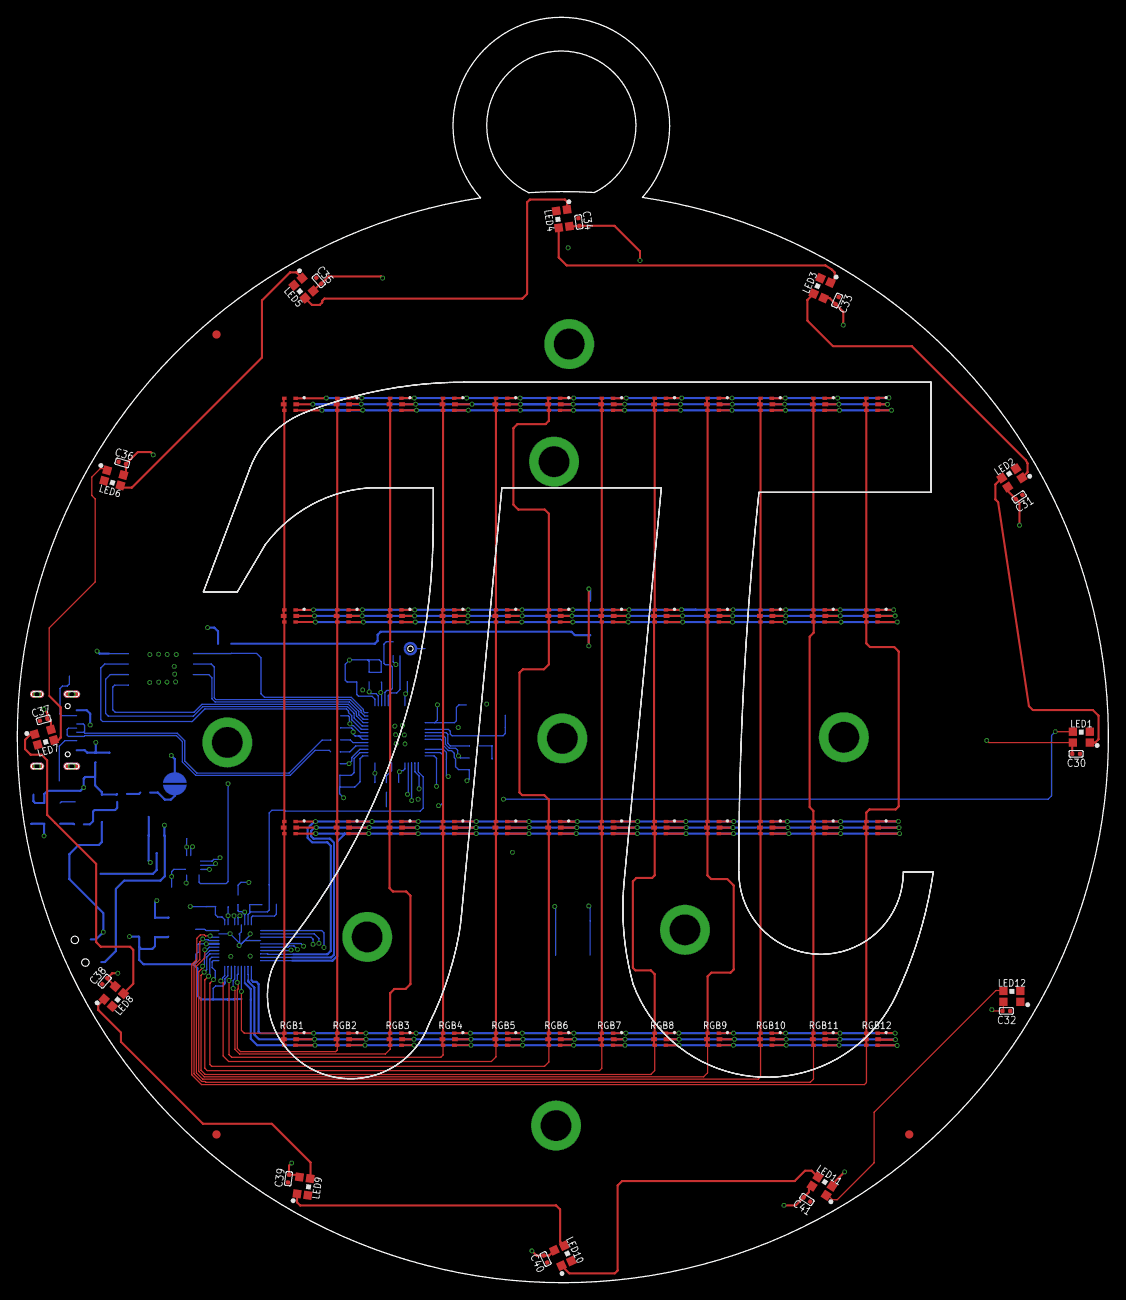
[picture p6: board piboard.brd from above]

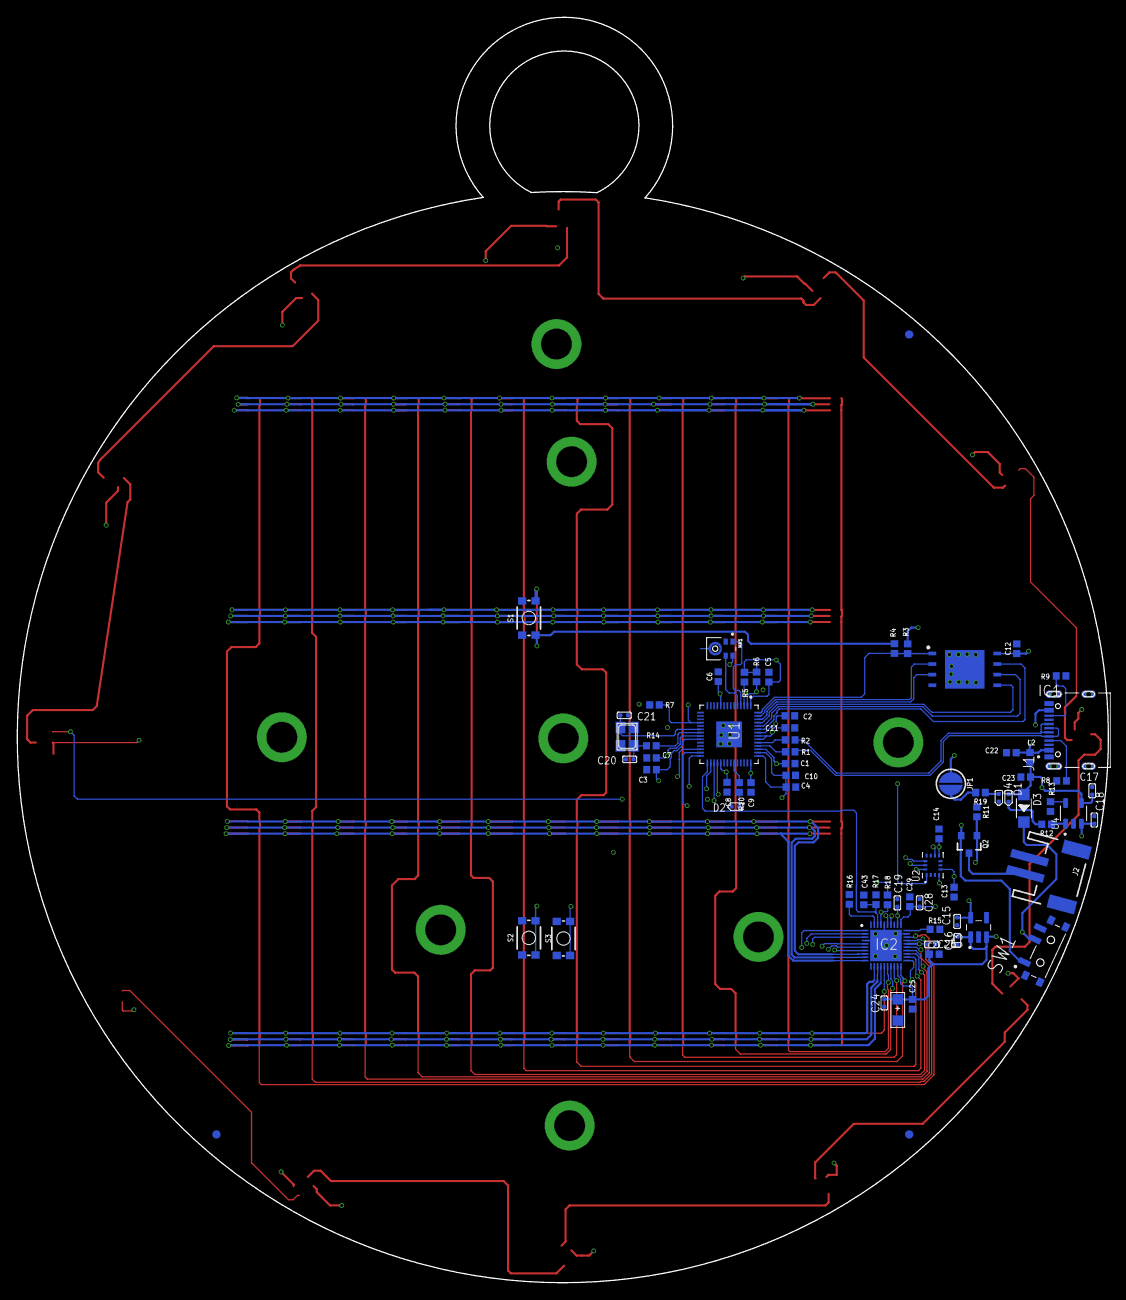
[picture p7: board piboard.brd from below]

Board: 4 copper layers, 131.0 x 151.9 mm, 157 parts (74 on the bottom side), 80 nets.
