sai-ydev/pibadge/arduino_code/sketch_feb23a/IS31FL3737RES.h

#ifndef __IS31FL3737RES_H__
#define __IS31FL3737RES_H__

/*********************************************************/
//************PWM???***********************************
/********************************************************/
const unsigned char all_pwm_on_IS31FL3737[192]
{
	0xff,0xff,0xff,0xff,0xff,0xff,0xff,0xff,0xff,0xff,0xff,0xff,0xff,0xff,0xff,0xff,
	0xff,0xff,0xff,0xff,0xff,0xff,0xff,0xff,0xff,0xff,0xff,0xff,0xff,0xff,0xff,0xff,
	0xff,0xff,0xff,0xff,0xff,0xff,0xff,0xff,0xff,0xff,0xff,0xff,0xff,0xff,0xff,0xff,
	0xff,0xff,0xff,0xff,0xff,0xff,0xff,0xff,0xff,0xff,0xff,0xff,0xff,0xff,0xff,0xff,
	0xff,0xff,0xff,0xff,0xff,0xff,0xff,0xff,0xff,0xff,0xff,0xff,0xff,0xff,0xff,0xff,
	0xff,0xff,0xff,0xff,0xff,0xff,0xff,0xff,0xff,0xff,0xff,0xff,0xff,0xff,0xff,0xff,
	0xff,0xff,0xff,0xff,0xff,0xff,0xff,0xff,0xff,0xff,0xff,0xff,0xff,0xff,0xff,0xff,
	0xff,0xff,0xff,0xff,0xff,0xff,0xff,0xff,0xff,0xff,0xff,0xff,0xff,0xff,0xff,0xff,
	0xff,0xff,0xff,0xff,0xff,0xff,0xff,0xff,0xff,0xff,0xff,0xff,0xff,0xff,0xff,0xff,
	0xff,0xff,0xff,0xff,0xff,0xff,0xff,0xff,0xff,0xff,0xff,0xff,0xff,0xff,0xff,0xff,
	0xff,0xff,0xff,0xff,0xff,0xff,0xff,0xff,0xff,0xff,0xff,0xff,0xff,0xff,0xff,0xff,
	0xff,0xff,0xff,0xff,0xff,0xff,0xff,0xff,0xff,0xff,0xff,0xff,0xff,0xff,0xff,0xff
};//pwm max data

/*********************************************************/
//************PWM??*************************************
/********************************************************/
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
0x69,	0x04,	0x34,	0x9C,	0xB8,	0xA7,	0x00,	0x00,	0x8A,	0x8C,	0x89,	0x85,	0x72,	0x73,	0x00,	0x00,
0x4E,	0x3F,	0x9C,	0xCC,	0xC0,	0xC7,	0x00,	0x00,	0xAB,	0x8C,	0x98,	0x90,	0x74,	0x69,	0x00,	0x00,
0x5E,	0x93,	0xBD,	0xAC,	0x95,	0xA3,	0x00,	0x00,	0xA6,	0x8F,	0x8A,	0x91,	0x88,	0x88,	0x00,	0x00,},
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
