sai-ydev/pibadge/(commit log)

2023-02-08 board files check-in
    [piboard.brd, piboard.sch]
2023-02-09 Daily check-in
    [piboard.brd, piboard.sch]
2023-02-13 Board check-in
    [piboard.brd, piboard.sch, piboard_bom.xlsx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]
2023-02-25 Arduino sketch
